MicheleBona/PEIP2_Arduino_ExploBot/README.md

# PEIP2_Arduino_ExploBot
Le projet Arduino 2018 de Michele Bona et Anthony Barna.

https://github.com/MicheleBona/PEIP2_Arduino_ExploBot/blob/master/documents/images/Explobot.jpg

Dans le cadre de notre projet de PeiP 2 nous avons créé l'ExploBot, un char tout terrain de petite taille alimenté par câble qui peut obtenir des images dans de nombreux endroits inaccessibles pour l'homme...

Il embarque avec lui une caméra et un flash pouvant tourner à 180° et est intégralement commandé à l'aide d'une manette de PlayStation 2.

Vous pourrez trouver ici une [vidéo de présentation](https://www.youtube.com/watch?v=P0yatlXfEzo&feature=youtu.be).
