MicheleBona/PEIP2_Arduino_ExploBot/Rapport Final.pdf

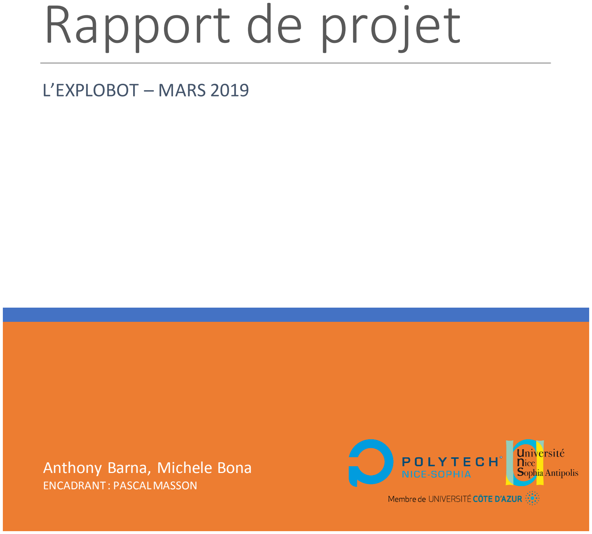
[picture p1: page 1]

### Anthony Barna, Michele Bona

ENCADRANT : PASCAL MASSON

# Rapport de projet

## L’EXPLOBOT – MARS 2019

Voici le rapport de l’ExploBot de Michele Bona et Anthony Barna. Notre projet est un véhicule tout-terrain étudié pour explorer des grottes, des couloirs, des décombres et autres terrains accidentés difficiles d’accès pour l’Homme…

L’ExploBot est contrôlé avec une manette de PlayStation 2 pour un contrôle précis des déplacements et est alimenté par batterie, ce qui lui garantit une certaine autonomie. En plus de la batterie notre explorateur embarque avec lui une caméra IP (qui retranscrit les images en temps réel sur un téléphone par Wifi) et une LED assez puissante pour rendre les images de la caméra perceptibles, même dans l’obscurité.

Le robot a une bonne mobilité et est assez agile. Il est compact(23.5cm de long, 18cm de large et 18cm de haut) et pèse moins de 2kg qui sont répartis vers l’avant pour faciliter le franchissement d’obstacles.

Le projet a été réalisé sur 8 séances, entre le 10 décembre et le 4 mars. Nous allons ici vous présenter notre travail en détail selon le plan qui suit…

Vous pourrez trouver ici une vidéo de présentation. (https://www.youtube.com/watch?v=P0yatlXfEzo&feature=youtu.be)

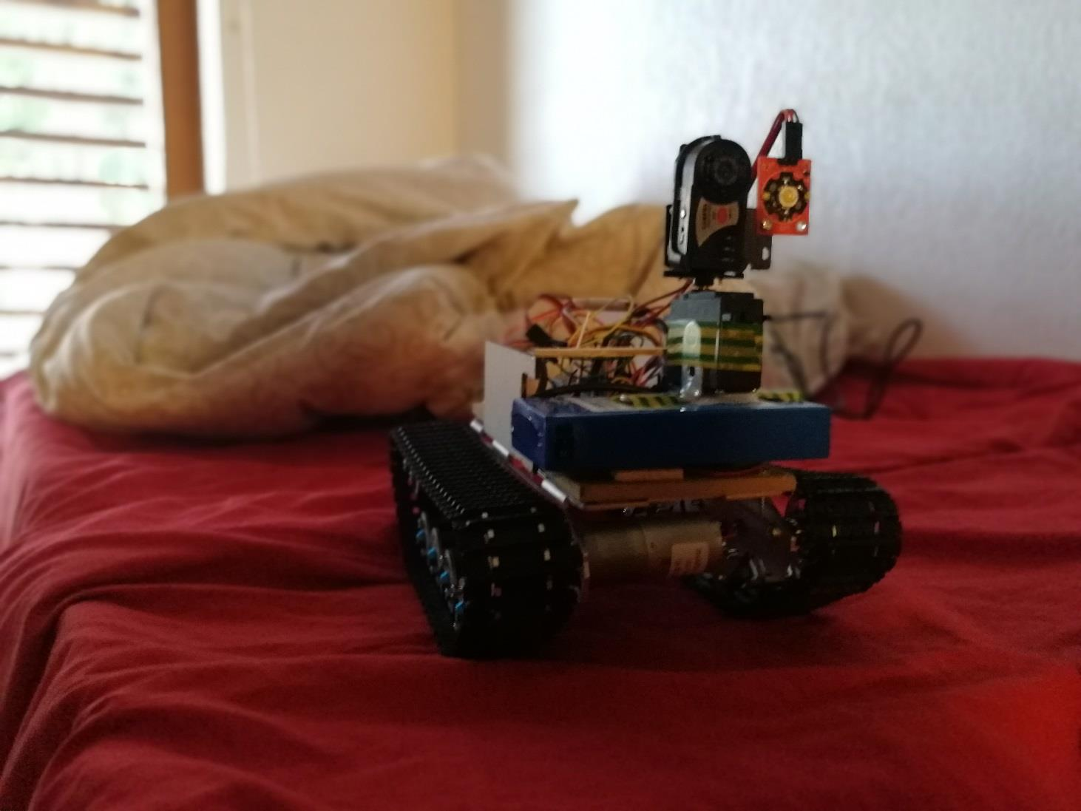
[picture p2: figure]
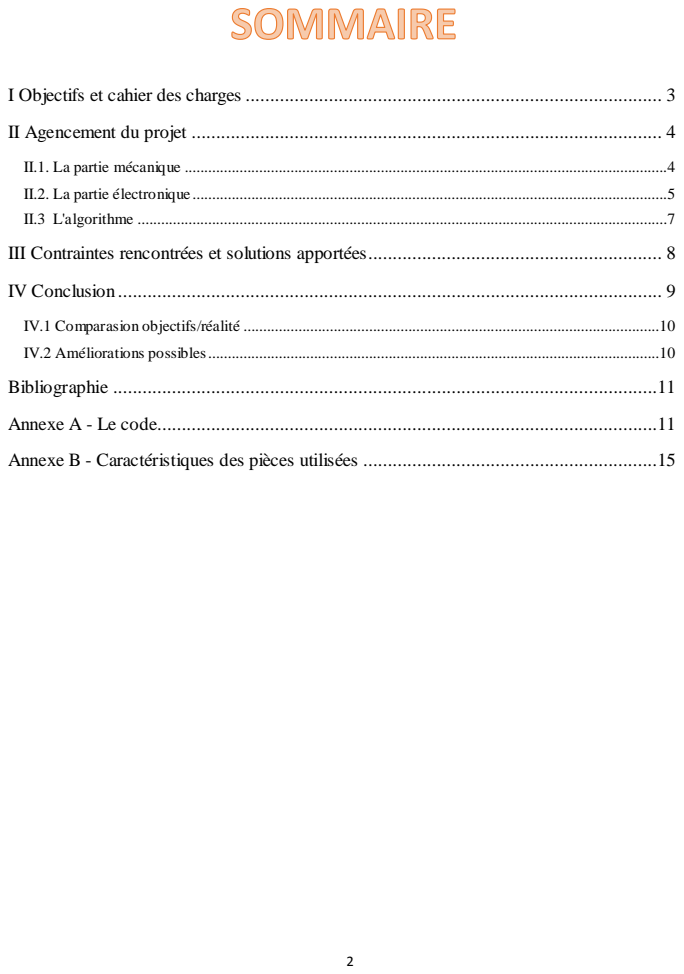
[picture p3: page 3]
IV Conclusion ............................................................................................................... 9; Bibliographie ...............................................................................................................11

I Objectifs et cahier des charges ..................................................................................... 3

II Agencement du projet ................................................................................................ 4

II.1. La partie mécanique ...........................................................................................................................4
II.2. La partie électronique .........................................................................................................................5
II.3 L'algorithme .......................................................................................................................................7

III Contraintes rencontrées et solutions apportées............................................................ 8

IV.1 Comparasion objectifs/réalité ..........................................................................................................10
IV.2 Améliorations possibles...................................................................................................................10

Annexe A - Le code......................................................................................................11

Annexe B - Caractéristiques des pièces utilisées ............................................................15

Nous avions imaginé l’ExploBot à la base comme un char « tout-terrain » qui avait pour objectif l’exploration de pyramides (avec caméra, lampe, détection d’obstacles, mapping de pièce et d’autres ajouts qui auraient été à préciser plus tard). Il devait être contrôlé par câble car les connections par ondes ne passent pas dans ces environnements.

Ce but primitif s’est ensuite généralisé à l’exploration de toute zone inaccessible comme des décombres ou des conduits. Nous avons donc jugé que l’accès à ces zones, la collecte et la récupération d’images et la mobilité du robot étaient nos priorités.

Nous voulions aussi un dérouleur de câble pour pouvoir transmettre des informations au robot même à grande distance.

Nous avons commencé par organiser notre travail en créant un GitHub et à réfléchir au montage de notre robot en s’inspirant de projets similaires. De cette réflexion est né le cahier des charges suivant :

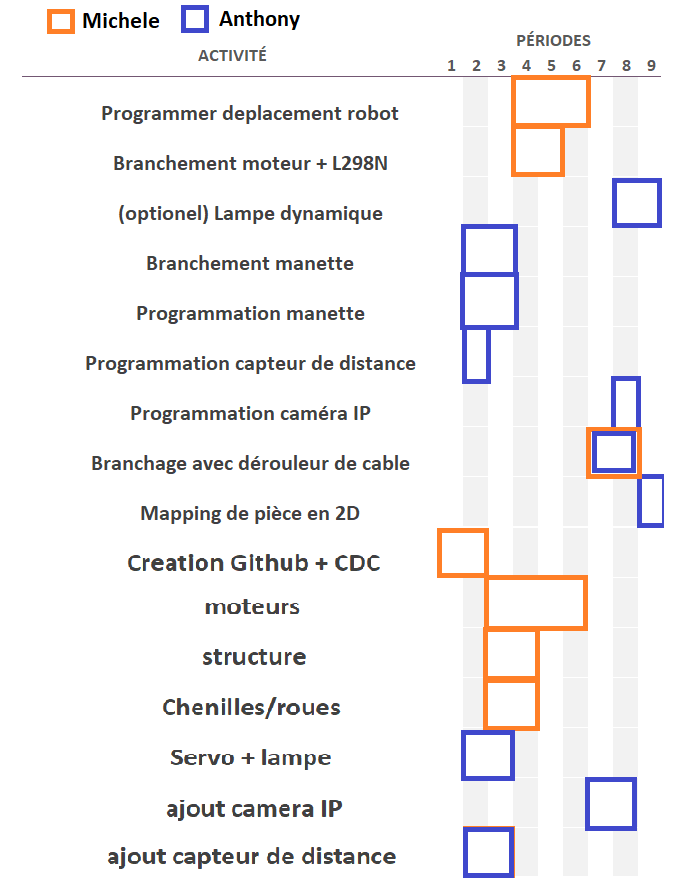
[picture p4: figure]

Nous nous sommes donnés pour objectif dans les premières semaines de créer la « base » du robot, c’est-à-dire d’avoir un châssis, des chenilles fonctionnelles et manipulables avec une manette.

L’idée étant qu’une fois la base terminée nous puissions nous concentrer sur l’ajout de la caméra et de la lampe, mais aussi des fonctionnalités secondaires (comme le capteur de distance ou encore le mapping 2D…).

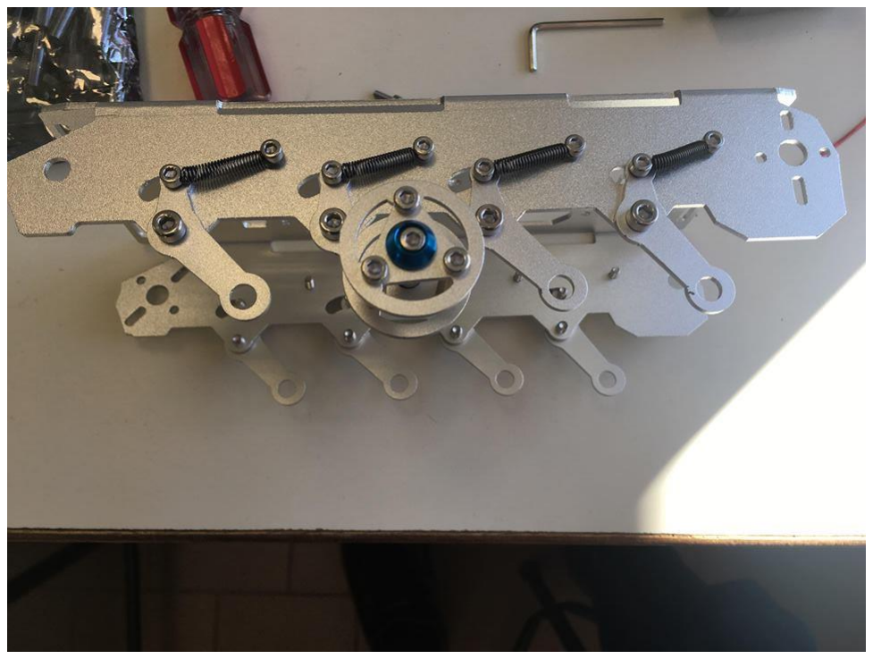
[picture p5: figure]

En ce qui concerne la partie mécanique de l’ExploBot, il est composé d’un châssis en alliage d’Aluminium où sont attachées 12 roues (6 par côté) et de deux moteurs 12V. Il y a de chaque côté la même structure : une roue motrice dentée connectée à un moteur pour entrainer la chenille, cinq roues dont quatre plus basses, attachées à des suspensions en Aluminium.

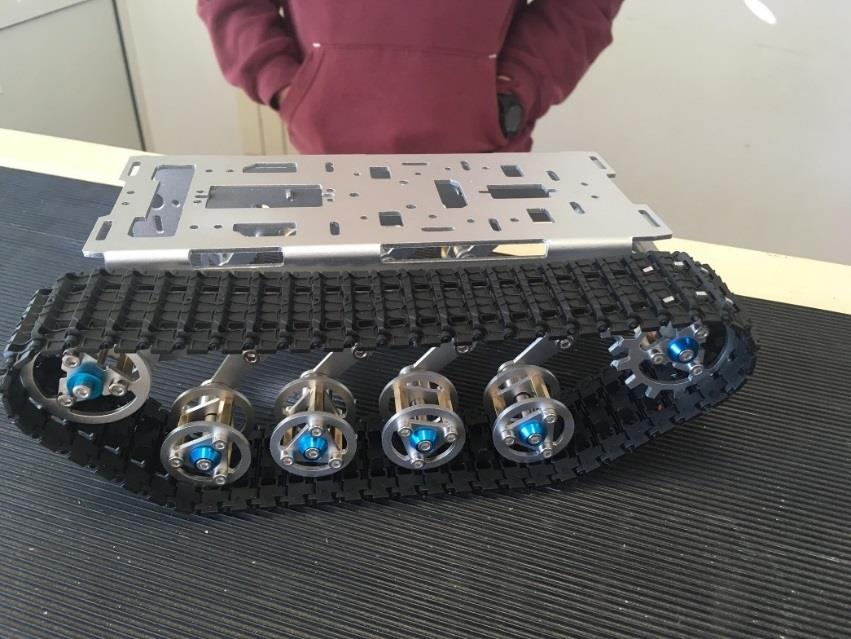
[picture p6: figure]

La chenille, elle, est en plastique. Elle a deux rangées de « dents » pour y caler les roues non-motrices au milieu et ainsi les bloquer. Mais aussi des trous pour les dents des roues motrices. On a par la suite fixé une planche de bois sur le châssis pour y installer la carte Arduino et les autres composants électroniques…

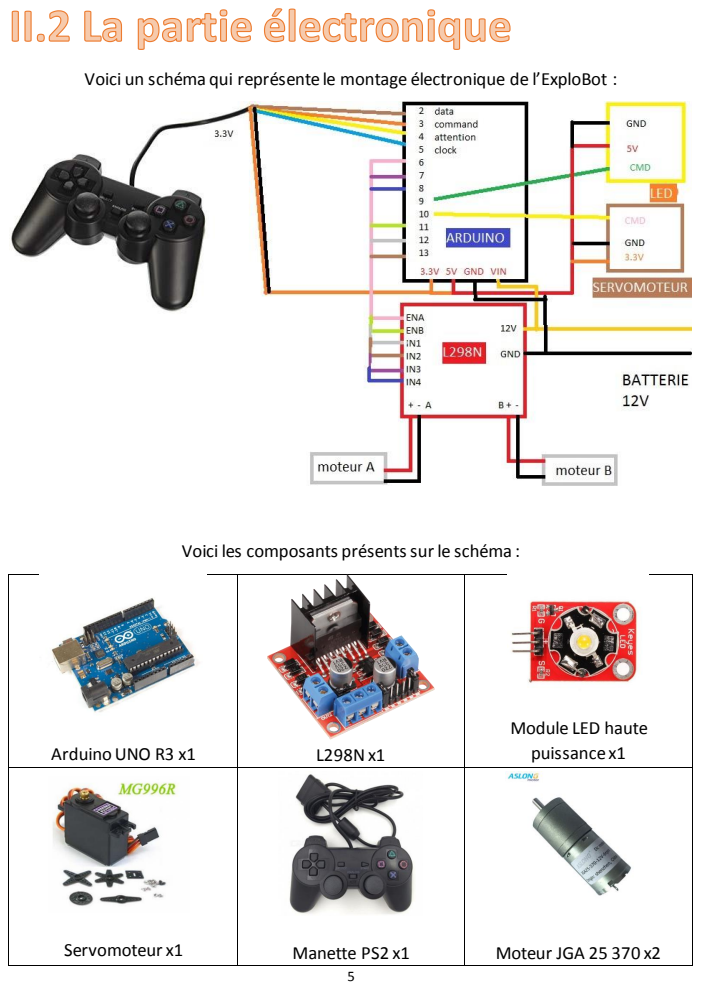
[picture p7: page 6]

Voici un schéma qui représente le montage électronique de l’ExploBot :

Voici les composants présents sur le schéma :

Arduino UNO R3 x1 | L298N x1 | Module LED haute puissance x1

Servomoteur x1 | Manette PS2 x1 | Moteur JGA 25 370 x2

Une batterie de 12V (ou un câble) alimente le module L298N (c’est un module qui va envoyer le courant désiré dans les deux moteurs à courant continu) qui va à son tour alimenter en 12V la carte Arduino qui possède une entrée appropriée.

Le UNO R3 possède deux alimentations : une en 5V et une en 3.3V. La manette et la LED haute puissance sont alimentées sur le 3.3V tandis que le servomoteur est alimenté sur le 5V.

La carte Arduino UNO R3 est programmable et contient un l’algorithme (cf II.3) qui lui permet d’interagir avec le reste des composants avec ses entrées et sorties numériques et analogiques. C’est « l’intelligence » du robot.

Le module L298N permet de faire passer un courant désiré dans un sens désiré dans un moteur, et peut gérer deux moteurs simultanément (il utilise le principe du double pont en H). Par exemple pour le moteur A, les entrées numériques IN1 et IN2 vont définir un sens de rotation (si IN1 vaut la valeur logique HAUT et que IN2 vaut la valeur logique BAS, le sens de rotation sera le sens inverse de celui imposé par les valeurs IN1 = BAS et IN2 = HAUT). Le module enverra un courant proportionnel à celui envoyé dans le port ENA (le courant maximal pour ENA = 5V et un courant nul pour ENA = 0V). Le principe est exactement le même pour le moteur B avec IN3, IN4 et ENB.

Le servomoteur est fait pour recevoir une information (un signal plus ou moins long en fonction de l’angle désiré) et en fonction de cette dernière, se positionner sur un angle compris entre 0 et 180 degrés.

La LED haute puissance reçoit une valeur logique haute ou basse, en fonction de cela elle va s’allumer ou s’éteindre.

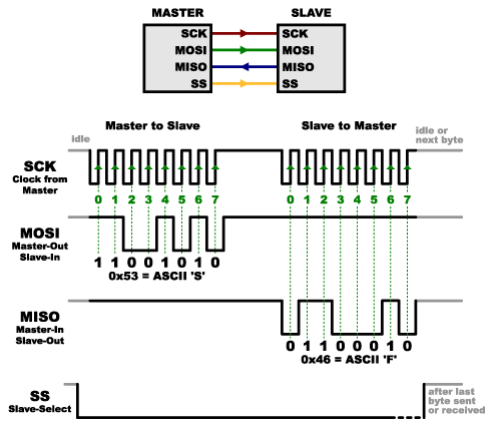
[picture p8: figure]

En ce qui concerne la manette, elle fonctionne
en liaison Serial Peripheral Interface. (https://fr.wikipedia.org/wiki/Serial_Peripheral_Interface) C’est un
mode de communication où la carte Arduino se positionne en maître et la manette en esclave. Au démarrage de l’ExploBot, une fréquence d’horloge est imposée par le maître (cf câble SCK). Ensuite des paquets d’octets vont être échangés entre le maître et l’esclave (par les câbles MOSI et MISO). En fonction de ces octets, l’algorithme va reconnaître les commandes de la manette. Le câble SS reste ici fixe car il n’y a qu’un seul esclave.

L’algorithme est programmé en langage C (une surcouche est apportée par Arduino). Il se décompose en deux grosses fonctions : la fonction setup() qui est exécutée une fois au démarrage de l’ExploBot et la fonction loop() qui est exécutée en boucle, après la fonction setup(). Voici un schéma qui explique ce que réalise l’algorithme.

# loop()

Lit les commandes envoyées par la manette

Si la touche triangle est pressée, on change alors l'état de la LED (de allumé à éteint ou l'inverse)

Si les flèches (gauche ou droite) sont pressées on change l'angle du servomoteur de manière à ce que ce dernier tourne à gauche ou à droite. Si la flèche du haut est appuyée, on revient à l'angle initial.

Si les joysticks sont utilisés, on envoie l'énergie dans les moteurs dans le sens et l'intensité indiquée. Le fonctionnement est expliqué ci-dessous.

# setup()

Nomme et définit (en entrée ou en sortie) les différents ports de la carte. Crée et/ou initialise les variables globales (Exp : l'angle attribué au servomoteur ou encore l'état de la LED).

En ce qui concerne les joysticks, la manette en possède deux. Celui de gauche indique la direction du robot, tandis que celui de droite indique l’intensité à fournir (pour avancer plus ou moins vite) et le sens de fonctionnement (marche avant ou arrière). Cette configuration permet une manipulation précise de l’ExploBot. Chaque joystick possède deux axes qui renvoient des valeurs comprises entre 0 et 255. Si on ne touche pas le joystick (au repos), il renverra alors 128 pour l’axe X et Y. Grâce à ces informations ont peut alors traiter les données renvoyées

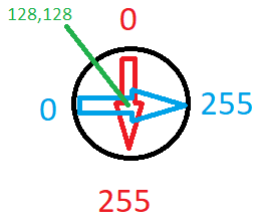
[picture p9: figure]

par les joysticks pour indiquer le sens de rotation (donc les valeurs respectives à envoyer dans les ports IN1, IN2, IN3 et IN4) et l’intensité (donc les valeurs respectives à envoyer dans ENA et ENB) des deux moteurs.

Pour plus d’informations sur le code de l’ExploBot, référez-vous à l’Annexe A.

Les principales contraintes rencontrées en ce qui concerne la partie mécanique de l’ExploBot ont été les suivantes :

- La recherche du « châssis parfait ». En effet pour qu’il puisse atteindre nos objectifs, nous avons cherché un châssis assez petit avec un bon rapport poids/puissance, mais aussi capable de déplacement précis et en « tout-terrain ». Initialement nous voulions le monter nous-mêmes de A à Z, mais le choix d’un kit de châssis de char avec chenille nous a permis de satisfaire toutes les contraintes mécaniques.
- Ensuite le montage du kit que nous avions reçu nous posa un problème… En effet il s’agissait d’un kit contenant de nombreuses pièces et il n’y avait aucun manuel ou tutoriel de montage en ligne. Néanmoins la structure étant symétrique et similaire aux autres modèles de ce type nous avons pu à force de temps le monter complètement.

- Enfin la qualité du matériel nous posa de nombreux problèmes tout au long du projet. En effet pour des raisons de budget la qualité de nos pièces n’était pas toujours excellente : les vis se desserraient souvent et le système prévu pour fixer l’axe moteur était très fragile. Il est arrivé deux fois qu’il casse et donc que le moteur tourne dans le vide. Nous avons donc utilisé les rechanges et essayé de consolider le tout avec de la colle forte. Cela a par la suite bien tenu.

En ce qui concerne la partie électronique et algorithmique, il n’y a pas eu de problème particulier, mis à part la gestion de la manette qui a pris beaucoup plus de temps que prévu et la première manette qui était défectueuse (qui a donc engendré la commande d’une deuxième et un retard dans notre emploi du temps).

Ainsi, entre le branchement de la manette, son montage (soudures éventuelles) et sa programmation (qui demandait d’utiliser et de comprendre la librairie PS2X, disponible sur le GitHub du projet), beaucoup de temps s’est écoulé.

À la fin des délais accordés, l’ExploBot est opérationnel et remplit parfaitement sa fonction principale, qui est d’obtenir des images depuis des endroits difficiles d’accès pour l’Homme (cf vidéo de présentation). (https://www.youtube.com/watch?v=P0yatlXfEzo&feature=youtu.be) Les objectifs de départ et le résultat obtenu diffèrent pourtant. Nous expliquons ci-dessous pourquoi et comment nous aurions pu atteindre ces objectifs ou encore ce que nous aurions aimé faire de plus si nous avions eu plus de temps.

Nous allons voir comment nous avons finalement géré notre temps, pour cela nous avons refait notre cahier des charges mais avec cette fois le temps réel que nous a pris chaque partie du projet.

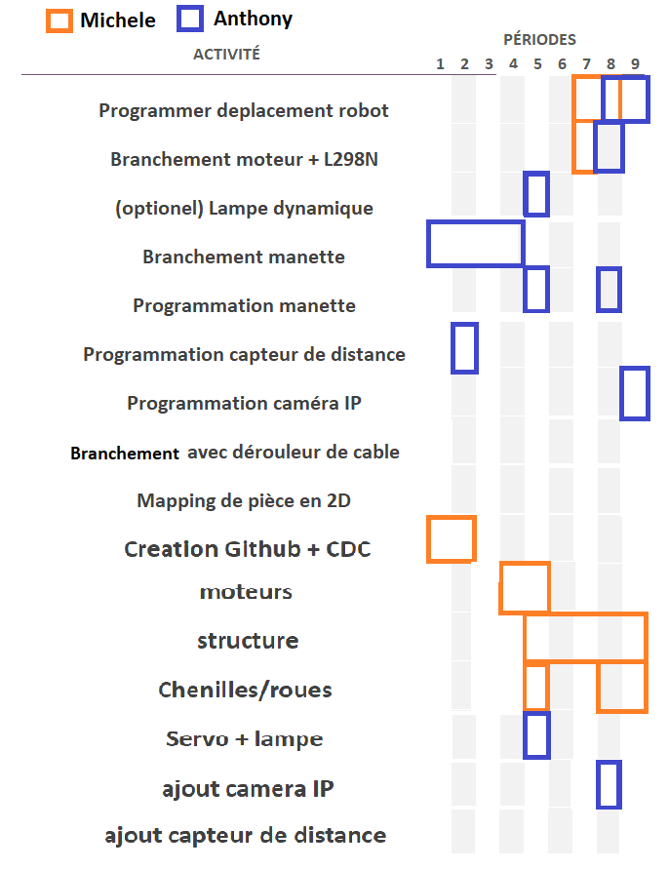
[picture p10: figure]

On peut remarquer que nous sommes en général restés dans les temps et que nous avons atteint la plupart de nos objectifs (le char est opérationnel et contrôlé par manette, la caméra embarquée et la LED sont branchées sur un servomoteur aussi contrôlé avec la manette).

Certains éléments comme on l’a vu dans la partie III nous ont pris plus de temps que prévu (en particulier le branchement de la manette et la fixation de la structure, car le châssis nous a posé des soucis jusqu’à la fin…).

Enfin par faute de temps, certains éléments n’ont pas été rajoutés (comme le capteur de distance (donc au passage le mapping de pièce) qui était déjà programmé et installable ou encore le dérouleur de câble car nous n’avions plus le temps d’en commander un).

Nous considérons que le cahier des charges initial était réalisable. Avec notre recul actuel, nous pensons qu’en ayant mieux optimisé notre temps (nos commandes, notre ordre de priorité…) nous aurions pu :

- Alimenter l’ExploBot par câble, à l’aide d’un dérouleur de câble qui aurait offert un grand champ de déplacement et plus de légèreté (la batterie est un poids non négligeable ajouté au robot).
- Ajouter un capteur de distance sur le servomoteur, et donc faire une analyse de l’environnement même sans luminosité et à une plus grande distance que par caméra.

Si nous avions plus de temps pour développer notre projet, en plus des améliorations citées ci-dessus, nous mettrions en place :

- Un nouvel axe de rotation pour la caméra qui nous permettrait de voir le sol et le plafond.
- Une meilleure protection du robot car il peut être amené à évoluer dans des milieux dangereux (chutes de gravats..).
- Une possibilité de passer facilement d’un mode filaire à un mode sans fil en fonction de l’environnement.

Voici une liste des sites qui nous ont aidé à développer notre projet :

- https://guides.github.com/activities/hello-world/
- https://github.com/madsci1016/Arduino-PS2X
- http://electrotuto.com/2014/04/24/manette-ps2-et-arduino-ps2-controler/
- https://www.youtube.com/watch?v=AgYTPRtgIOc&t=13s&index=243&list=WL
- http://store.curiousinventor.com/guides/PS2/
- https://www.robotshop.com/community/blog/show/dimensionnement-dun-moteur-dentranement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 (https://www.robotshop.com/community/blog/show/dimensionnement-dun-moteur-dentranement)
- https://www.youtube.com/watch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 (https://www.youtube.com/watch?reload=9&v=-9WLhvXwGhw)

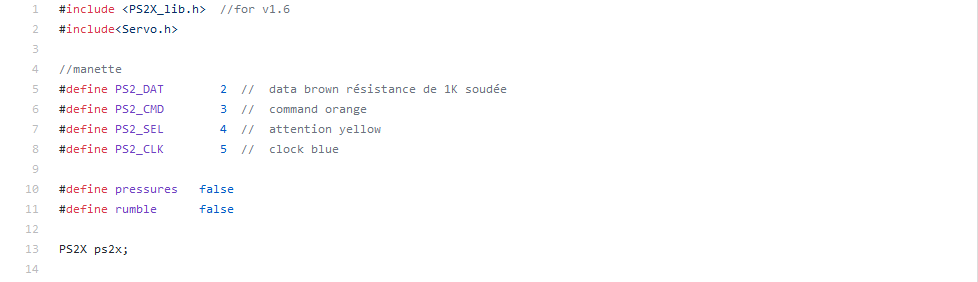
[picture p11: figure]
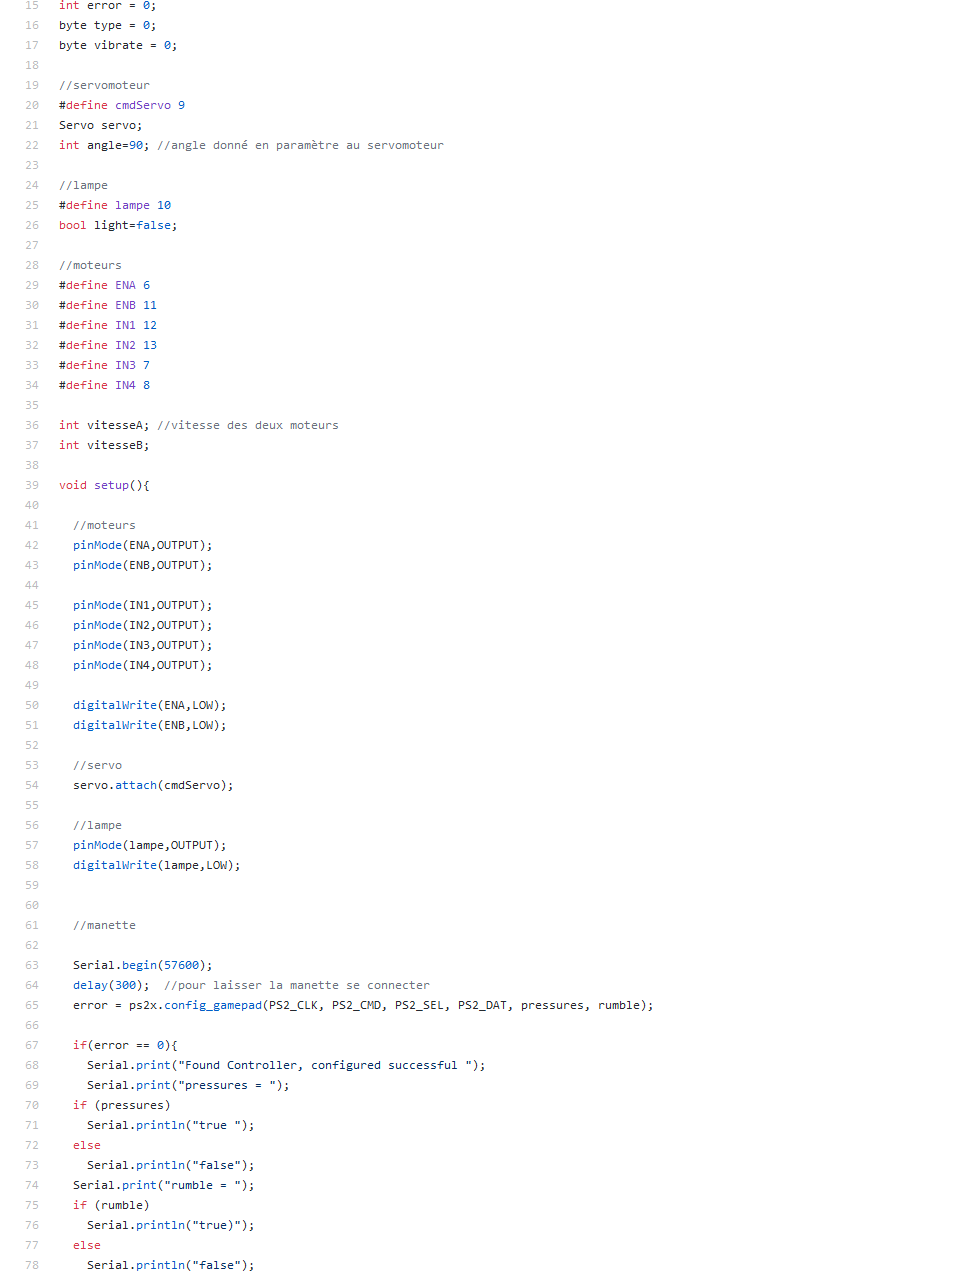
[picture p12: page 13]
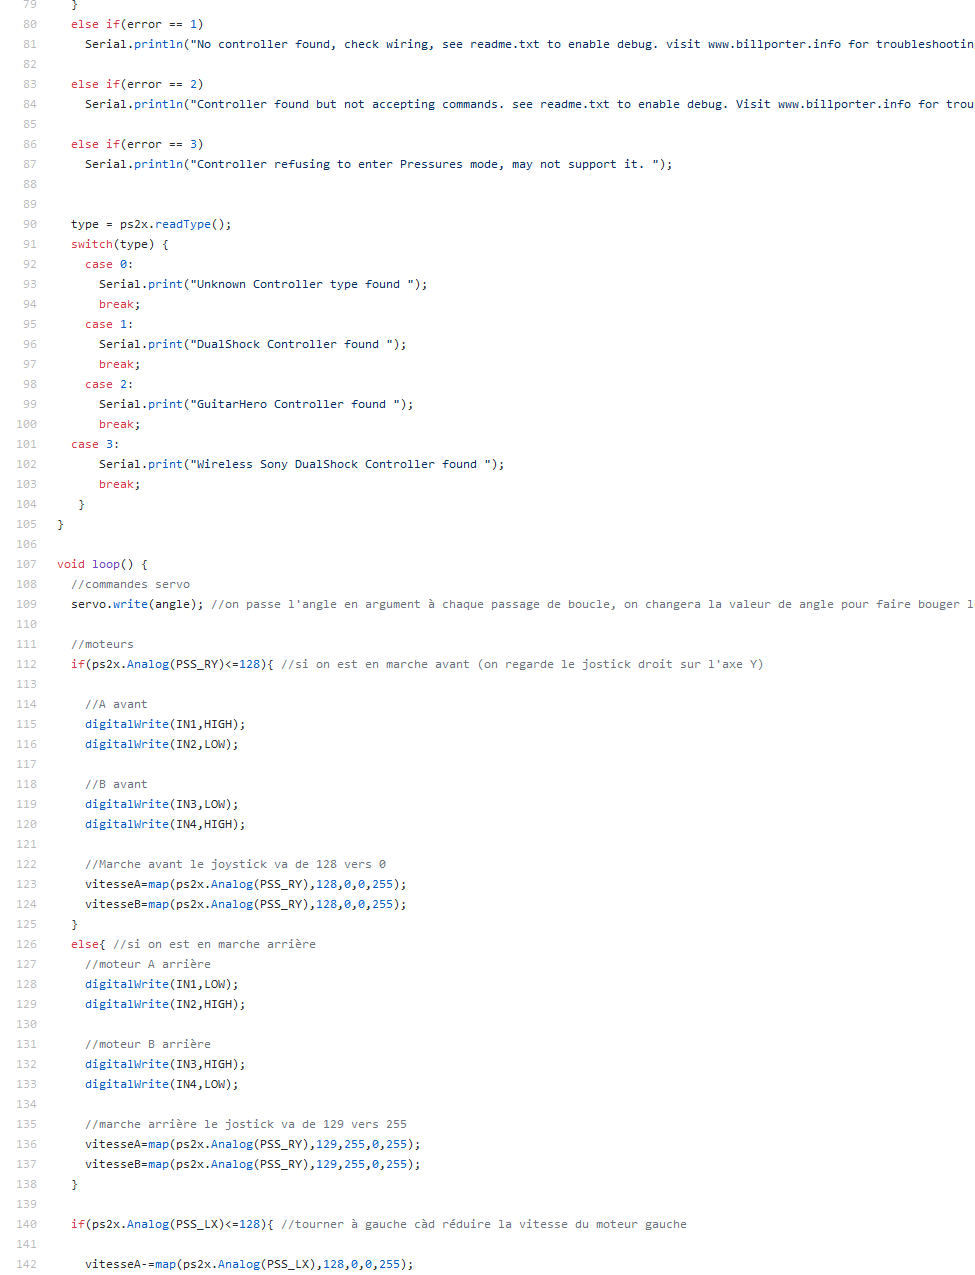
[picture p13: page 14]
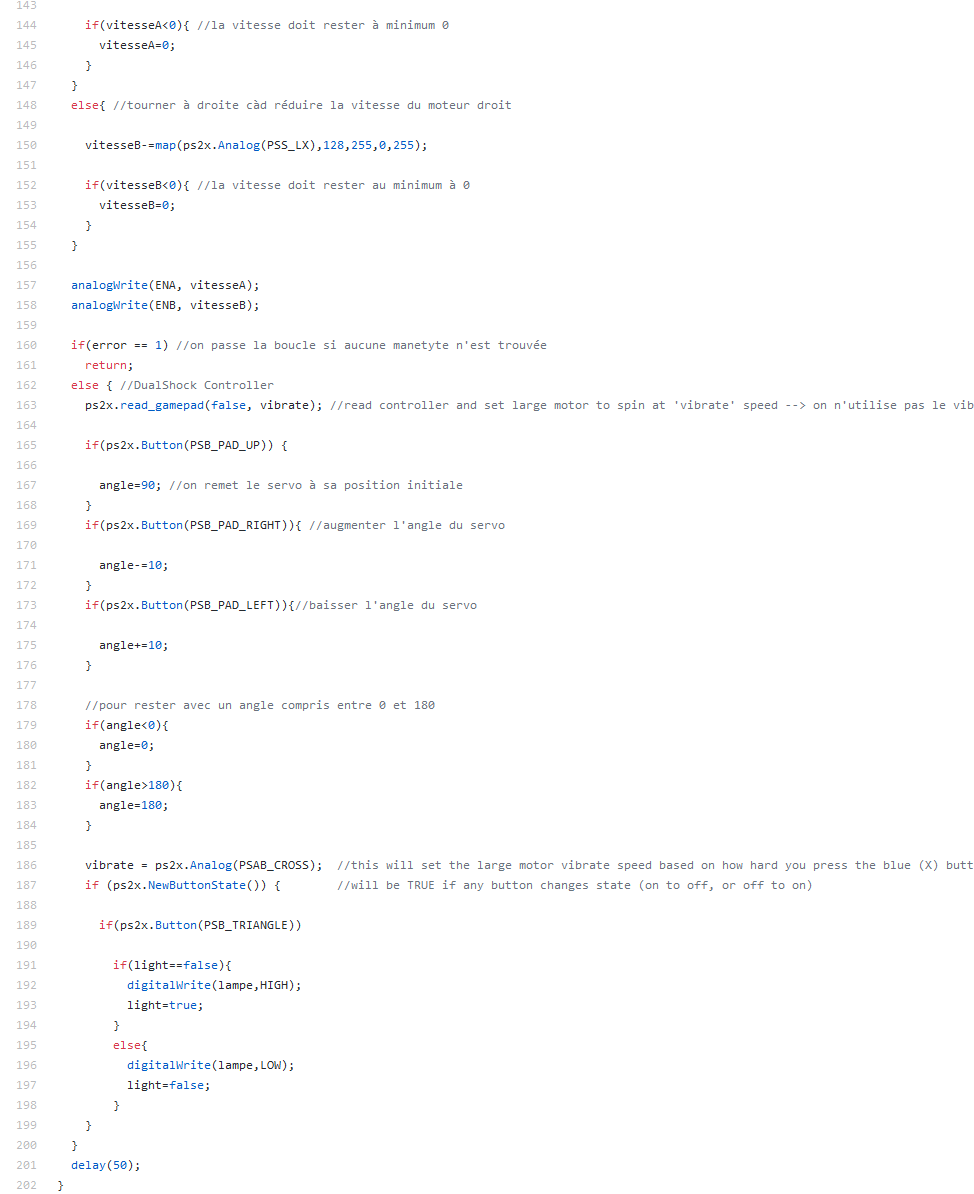
[picture p14: page 15]
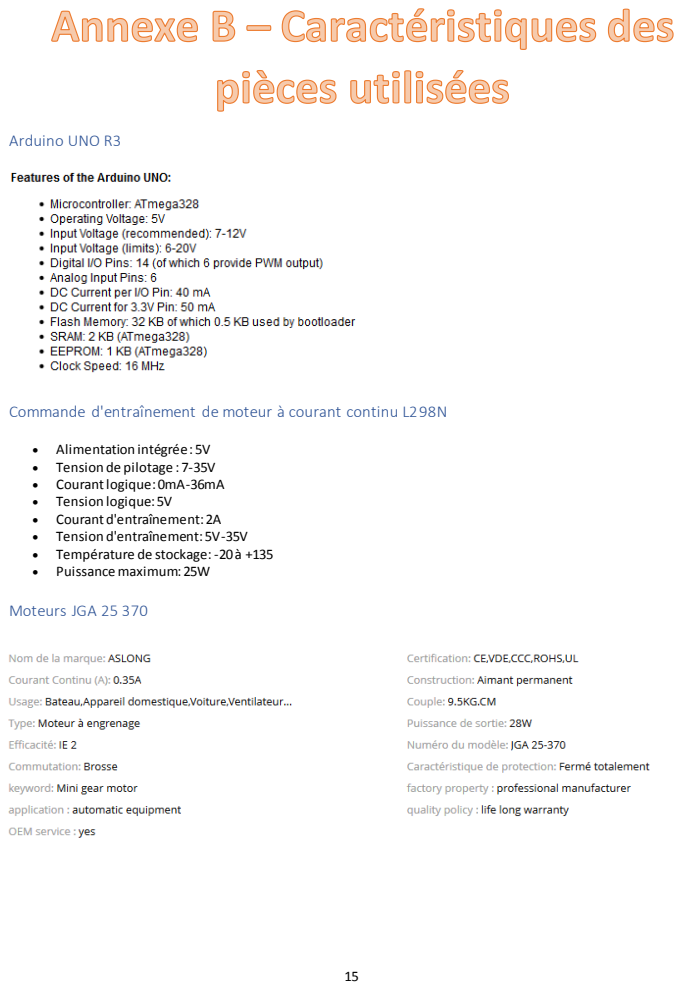
[picture p15: page 16]
Arduino UNO R3; Moteurs JGA 25 370

Commande d'entraînement de moteur à courant continu L298N

• Alimentation intégrée : 5V
• Tension de pilotage : 7-35V
• Courant logique: 0mA-36mA
• Tension logique: 5V
• Courant d'entraînement: 2A
• Tension d'entraînement: 5V-35V
• Température de stockage: -20 à +135
• Puissance maximum: 25W

Servomoteur Tower Pro MG 996R

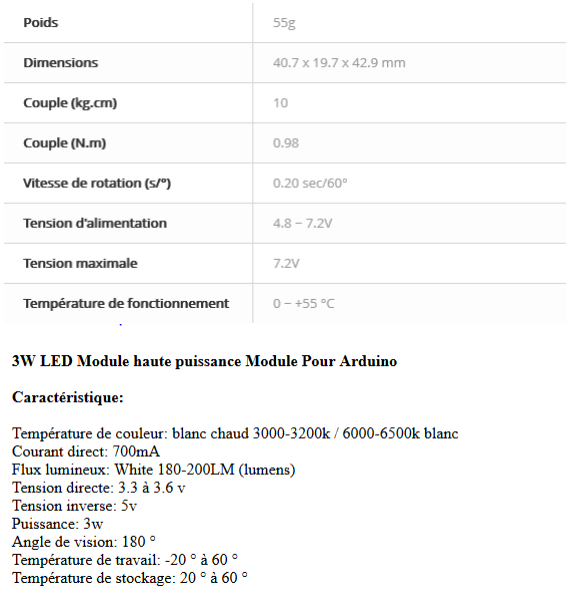
[picture p16: figure]
